vlaate/vladsc/(commit log)

2017-04-22 Changed to use LSM303
    improved top use an integrated magnetometer+accelerometer, with tilt compensation.
    Improved network code for faster responsiveness in skysafari
    Improved smoothing algorithm for smooth readings when moving slowly, and fast updates when not.
2017-05-22 Schematic of the circuit
